Jorgeherrera-hub/Proyecto-Electr-nica-Biom-dica-/bioreactor v3/Guía de conexiones y funciones control del mini-biorreactor.docx

# Guía de conexiones y funciones: control del mini-biorreactor

Placa mini_biorreactor: 39 componentes y 4 agujeros de montaje. Los valores salen del esquemático generado y las conexiones, de la tabla de redes ya revisada contra la netlist.

## 1. Cómo usar esta guía

Para redibujar el esquemático en KiCad, trabaja por bloques (secciones 3.A a 3.G) y conecta con etiquetas de red (tecla L) usando exactamente los nombres de la sección 2, que son los de la placa. Así el esquemático coincide con la netlist. Al terminar, marca los pines no usados del ESP32 con la bandera de no conectado (sección 3.C), pon un PWR_FLAG en +12V_PROT y ejecuta el ERC.

Símbolos de KiCad que ya se confirmaron como existentes: RF_Module:ESP32-WROOM-32, Regulator_Linear:L7805 (solo como sustituto de U2, que físicamente es un OKI-78SR-5/1.5-W36-C), Regulator_Linear:LM1117T-3.3, Transistor_FET:IRLZ44N, BSS138, Device:D_Schottky, Connector:Conn_01xNN_Pin (headers y bornera), Switch:SW_Push, y Device:R y Device:C para resistencias y condensadores.

## 2. Redes (nombres iguales a los de la placa)

- +12V_IN: los 12 V que entran por la bornera, antes del diodo de protección.
- +12V_PROT: los 12 V después del diodo; alimentan el motor y el regulador de 5 V.
- +5V: salida del regulador de 5 V; alimenta la pantalla y el LM1117.
- +3V3: salida del LM1117; alimenta el ESP32 y los sensores.
- GND: tierra común.
- MOTOR-: terminal negativo del motor (drenaje del MOSFET).
- PWM_MOTOR: señal PWM del ESP32 (IO18).
- N$1: compuerta del MOSFET.
- N$2: botón ON/OFF (IO25).
- N$3: botón de regulación (IO26).
- EN, IO0: reinicio y modo de arranque del ESP32.
- TXD0, RXD0: puerto serie de programación.
- TEMP_DATA: dato de la sonda de temperatura (IO4).
- RPM_SIGNAL: pulsos del sensor de velocidad (IO19).
- SDA_3V3, SCL_3V3: I2C del lado del ESP32 (IO21, IO22).
- SDA_5V, SCL_5V: I2C del lado de la pantalla.

## 3. Conexiones por bloque (pin a pin)

### 3.A Entrada de alimentación y protección

- J1 (bornera de 2 pines): pin 1 → +12V_IN; pin 2 → GND.
- D1 (1N5819): ánodo (pin 2) → +12V_IN; cátodo (pin 1) → +12V_PROT.
- C1 (220 µF, 25 V): pin 1 → +12V_PROT; pin 2 → GND. Es polarizado: el terminal positivo va del lado de +12V_PROT (revisa la marca + de la serigrafía).
- C2 (100 nF): pin 1 → +12V_PROT; pin 2 → GND.

### 3.B Reguladores de 5 V y de 3,3 V

- U2 (OKI-78SR-5/1.5-W36-C, símbolo L7805): pin 1 (IN) → +12V_PROT; pin 2 (GND) → GND; pin 3 (OUT) → +5V.
- C3 (10 µF), C4 (100 nF), C5 (10 µF), C6 (100 nF): en los cuatro, pin 1 → +5V y pin 2 → GND. Se reparten entre la salida de U2 y la entrada de U3.
- U3 (LM1117T-3.3): pin 1 (GND) → GND; pin 2 (VO) → +3V3; pin 3 (VI) → +5V. Ojo: este orden de pines es distinto al del 7805.
- C7 (10 µF), C8 (100 nF), C9 (100 nF): en los tres, pin 1 → +3V3 y pin 2 → GND. C9 va junto al pin de alimentación del ESP32.

### 3.C ESP32, reinicio y programación

U1 (ESP32-WROOM-32), pines usados:

- Pin 2 (VDD) → +3V3.
- Pines 1, 15, 38 y 39 (GND) → GND.
- Pin 3 (EN) → EN.
- Pin 25 (IO0) → IO0.
- Pin 35 (TXD0/IO1) → TXD0.
- Pin 34 (RXD0/IO3) → RXD0.
- Pin 30 (IO18) → PWM_MOTOR.
- Pin 31 (IO19) → RPM_SIGNAL.
- Pin 26 (IO4) → TEMP_DATA.
- Pin 33 (IO21) → SDA_3V3.
- Pin 36 (IO22) → SCL_3V3.
- Pin 10 (IO25) → N$2.
- Pin 11 (IO26) → N$3.

Componentes de arranque:

- R1 (10 kΩ): pin 1 → +3V3; pin 2 → EN.
- C10 (100 nF): pin 1 → EN; pin 2 → GND.
- SW_EN: pin 1 → EN; pin 2 → GND.
- R2 (10 kΩ): pin 1 → +3V3; pin 2 → IO0.
- SW_BOOT: pin 1 → IO0; pin 2 → GND.
- J_PROG (6 pines): 1 → +3V3; 2 → TXD0; 3 → RXD0; 4 → EN; 5 → IO0; 6 → GND.

Pines de U1 sin uso (ponles la bandera de no conectado): SENSOR_VP (4), SENSOR_VN (5), IO34 (6), IO35 (7), IO32 (8), IO33 (9), IO27 (12), IO14 (13), IO12 (14), IO13 (16), SHD/SD2 (17), SWP/SD3 (18), SCS/CMD (19), SCK/CLK (20), SDO/SD0 (21), SDI/SD1 (22), IO15 (23), IO2 (24), IO16 (27), IO17 (28), IO5 (29) e IO23 (37).

### 3.D Control del motor

- R3 (100 Ω): pin 1 → PWM_MOTOR; pin 2 → N$1.
- R4 (10 kΩ): pin 1 → N$1; pin 2 → GND.
- Q1 (IRLZ44N): pin 1 (G) → N$1; pin 2 (D) → MOTOR-; pin 3 (S) → GND.
- J_MOTOR (2 pines): pin 1 → +12V_PROT; pin 2 → MOTOR-.
- D2 (1N5819): cátodo (pin 1) → +12V_PROT; ánodo (pin 2) → MOTOR-.
- C11 (100 nF): pin 1 → +12V_PROT; pin 2 → MOTOR-.

### 3.E Sensores

- J_TEMP (3 pines): 1 → +3V3; 2 → TEMP_DATA; 3 → GND.
- R5 (4,7 kΩ): pin 1 → +3V3; pin 2 → TEMP_DATA.
- J_RPM (3 pines): 1 → +3V3; 2 → RPM_SIGNAL; 3 → GND.
- R6 (10 kΩ): pin 1 → +3V3; pin 2 → RPM_SIGNAL.

### 3.F Pantalla LCD por I2C (con adaptador de nivel)

- Q2 (BSS138, línea SDA): pin 1 (G) → +3V3; pin 2 (S) → SDA_3V3; pin 3 (D) → SDA_5V.
- R7 (10 kΩ): pin 1 → +3V3; pin 2 → SDA_3V3.
- R8 (10 kΩ): pin 1 → +5V; pin 2 → SDA_5V.
- Q3 (BSS138, línea SCL): pin 1 (G) → +3V3; pin 2 (S) → SCL_3V3; pin 3 (D) → SCL_5V.
- R9 (10 kΩ): pin 1 → +3V3; pin 2 → SCL_3V3.
- R10 (10 kΩ): pin 1 → +5V; pin 2 → SCL_5V.
- J_LCD (4 pines): 1 → GND; 2 → +5V; 3 → SDA_5V; 4 → SCL_5V.

### 3.G Botones

- SW_ON: pin 1 → N$2; pin 2 → GND.
- SW_REG: pin 1 → N$3; pin 2 → GND.
- No llevan resistencia externa: el firmware debe activar las resistencias internas de pull-up de IO25 e IO26.

## 4. Función de cada componente

### Alimentación

- J1: bornera donde entra la fuente de 12 V.
- D1: protección contra polaridad invertida. Si conectas la fuente al revés, el diodo no deja pasar corriente. A cambio, cae unas décimas de voltio.
- C1: reserva de energía del riel de 12 V; amortigua los picos que genera el motor.
- C2: filtra el ruido de alta frecuencia del riel de 12 V.
- U2: regulador conmutado que baja 12 V a 5 V. Es mucho más eficiente que un 7805 y no se calienta como él. Alimenta solo la parte lógica; el motor toma los 12 V directamente.
- C3 a C6: estabilizan y filtran el riel de 5 V, a la salida de U2 y a la entrada de U3.
- U3: regulador lineal que baja 5 V a 3,3 V para el ESP32 y los sensores.
- C7 a C9: estabilizan la salida de 3,3 V. El LM1117 necesita un condensador de salida para ser estable, y C9 desacopla el ESP32.

### Microcontrolador y arranque

- U1 (ESP32-WROOM-32): el cerebro. Genera el PWM del motor, mide temperatura y RPM, maneja la pantalla y los botones, y trae WiFi y Bluetooth.
- R1: pull-up de EN; mantiene el ESP32 encendido.
- C10: filtra rebotes y da un pequeño retardo de arranque en EN.
- SW_EN: reinicio manual (lleva EN a GND).
- R2: pull-up de IO0; asegura el arranque normal.
- SW_BOOT: al mantenerlo pulsado mientras se reinicia, el ESP32 entra en modo de programación.
- J_PROG: conexión del adaptador USB-UART para cargar el programa. Con 12 V presentes, no conectes el pin 3V3 del adaptador.

### Motor (agitación)

- Q1 (IRLZ44N): interruptor electrónico. El ESP32 lo enciende y apaga muy rápido (PWM) y así regula la velocidad del agitador.
- R3: limita la corriente de carga de la compuerta, lo que suaviza los cambios y reduce ruido.
- R4: pull-down de la compuerta; mantiene el MOSFET apagado mientras el ESP32 arranca, para que el motor no gire solo al encender.
- D2: diodo de rueda libre. Absorbe el pico de tensión que produce el motor (una carga inductiva) cuando el MOSFET se apaga, y protege a Q1.
- C11: reduce el ruido eléctrico del motor.
- J_MOTOR: conector del motor de 6 V.

### Sensores

- J_TEMP: conector de la sonda de temperatura DS18B20 (3 hilos).
- R5: pull-up de 4,7 kΩ del bus de datos de la sonda; el DS18B20 lo necesita para comunicarse.
- J_RPM: conector del sensor Hall que mide la velocidad de agitación.
- R6: pull-up de la salida del sensor de velocidad.

### Pantalla

- J_LCD: conector de la pantalla LCD 16x2 con módulo I2C, que funciona a 5 V.
- Q2 y Q3 (BSS138): adaptador de nivel bidireccional entre el I2C de 3,3 V del ESP32 y el de 5 V de la pantalla (uno para SDA y otro para SCL). Protegen los pines del ESP32.
- R7 y R9: pull-ups de 3,3 V de SDA y SCL. R8 y R10: pull-ups de 5 V de SDA y SCL. Trabajan junto con Q2 y Q3.

### Botones

- SW_ON: enciende y apaga el agitador.
- SW_REG: regulación de velocidad. Con un solo botón, el firmware debe ciclar entre velocidades predefinidas.

### Mecánica

- H1 a H4: cuatro agujeros de montaje M3 para fijar la placa.

## 5. Piezas externas conectadas a la placa (no están en ella)

- Motor DC de 6 V → J_MOTOR.
- Sensor Hall con un imán en el eje → J_RPM.
- Sonda DS18B20 impermeable → J_TEMP.
- Pantalla LCD 16x2 con módulo I2C → J_LCD.
- Adaptador USB-UART → J_PROG (solo GND, TX y RX).
- Fuente de 12 V → J1.

## 6. Notas importantes

- El motor es de 6 V y el riel es de 12 V: el firmware debe limitar el PWM a un 50 % como máximo. Se sugiere una frecuencia de unos 20 kHz.
- D1 y D2 (1N5819) soportan 1 A: confirma que el motor no consuma más.
- C1 es polarizado. Si C3, C5 o C7 resultan ser electrolíticos y no cerámicos, el terminal positivo va al riel (+5V o +3V3).
- Qué condensadores de 10 µF y 100 nF están más cerca de U2 y cuáles de U3 no lo da la tabla de redes; en el esquemático basta con conectarlos al riel que corresponde.

## 7. Lista de verificación al redibujar

1. Coloca los 39 componentes con las mismas referencias y valores.
2. Conecta bloque por bloque con etiquetas de red de la sección 2.
3. Marca los 22 pines no usados de U1 con la bandera de no conectado.
4. Pon un PWR_FLAG en +12V_PROT.
5. Ejecuta el ERC y revisa que no queden errores.
6. Ejecuta el DRC de la placa con la comprobación de paridad con el esquemático (solo compara, no cambia nada).
