Jorgeherrera-hub/Proyecto-Electr-nica-Biom-dica-/bioreactor v3/Poryecto_bioreactor/Hoja de conexiones v3 control del mini-biorreactor con Arduino Nano R3.docx

# Hoja de conexiones v3: control del mini-biorreactor con Arduino Nano R3

Versión 3: la placa de desarrollo central pasa de ESP32 a Arduino Nano R3 (ATmega328P, lógica de 5 V). Parte del diseño v2 ya revisado. Las características de la Nano que se usan (pines PWM, interrupciones, I2C en A4 y A5, lógica de 5 V, VIN de 7 a 12 V) son estándar de la placa. Los nombres exactos de símbolo y huella en KiCad debes confirmarlos en tu selector, y el módulo de alarma, los sensores y la Nano concreta tienen puntos por confirmar al final (sección 4).

- El conversor del Arduino Nano R3 es CH340

## 1. Análisis de cambios (ESP32 frente a Arduino Nano R3)

### Lógica y voltajes

- El ESP32 trabaja a 3,3 V y la Nano a 5 V: todas las señales de la Nano son de 5 V.
- Se elimina el regulador U3 (LM1117T-3.3) junto con C7 y C8, y desaparece la red +3V3. Todo el circuito pasa a funcionar con la red +5V.
- Se elimina el adaptador de nivel I2C (Q3, R9 y R10). El I2C va directo de la Nano (5 V) a la pantalla (5 V). Q2, R7 y R8 se reutilizan como driver de la alarma.
- J_TEMP pin 1, J_RPM pin 1, R5 y R6 pasan de +3V3 a +5V. La sonda DS18B20 acepta 5 V (confirmado). Para el sensor de RPM se recomienda un módulo Hall A3144 (ver 2.E).
- La compuerta del IRLZ44N pasa a excitarse con 5 V desde la Nano, lo cual lo satura mejor que con 3,3 V.

### Alimentación

- La Nano se alimenta por su pin +5V desde la salida del buck U2. Los pines VIN y +3V3 de la Nano quedan sin conectar.
- Motivo de no usar VIN: pasa por el regulador lineal de la Nano, que con unos 11,6 V de entrada se calentaría y desperdiciaría potencia. El buck U2 es más eficiente.
- El pin +3V3 de la Nano sale del chip USB y entrega muy poca corriente, así que no se usa.

### Asignación de pines (ESP32 a Nano)

- PWM_MOTOR: de IO18 a D9. D9 es una salida PWM del Timer1, que permite subir la frecuencia a unos 31 kHz (fuera del rango audible) sin afectar a millis().
- RPM_SIGNAL: de IO19 a D2, que es la interrupción externa INT0. Es el pin ideal para contar pulsos.
- TEMP_DATA: de IO4 a D4 (bus OneWire; funciona en cualquier pin digital).
- SDA: de IO21 a A4. SCL: de IO22 a A5. En la Nano el I2C por hardware es fijo en esos dos pines.
- Botón ON/OFF (SW_ON): de IO25 a D5. Botón de regulación (SW_REG): de IO26 a D6.
- Navegación (SW_NAV): nuevo, en D7. Reutiliza el pulsador que era SW_BOOT.
- Alarma: nuevo, en D8.
- Reinicio (SW_RESET): va al pin ~RESET. Reutiliza el pulsador que era SW_EN.

### Botones en la carcasa

- Los botones de ON/OFF, regulación y navegación (D5, D6 y D7) pasan a ser botones de panel en la carcasa, conectados a la PCB por conectores de 2 pines: J_BTN_ON, J_BTN_REG y J_BTN_NAV.
- SW_RESET se queda en la PCB, dentro de la carcasa: un reinicio accidental desde el panel interrumpiría el control del agitador.
- Los nombres de red y los pines de la Nano no cambian: solo cambia dónde está físicamente cada interruptor.

### Interrupciones, PWM e I2C

- Interrupciones externas por hardware: solo D2 (INT0) y D3 (INT1). D3 queda libre y reservada.
- Pines con PWM: D3, D5, D6, D9, D10 y D11.
- A6 y A7 son solo entradas analógicas (no sirven como digitales ni tienen pull-up).
- D13 tiene el LED de la placa: no la uses para botones.

### Programación y reinicio

- La Nano se programa por su puerto USB con el bootloader. No existen los pines EN, IO0 ni BOOT del ESP32.
- D0 (RX) y D1 (TX) se comparten con el conversor USB: se dejan sin conexión.
- Por eso se elimina J_PROG, y R1 y R2 (pull-ups de EN e IO0) dejan de tener sentido.

### Corriente por pin y capacidades que se pierden

- Corriente recomendada por pin de la Nano: 20 mA (máximo absoluto 40 mA). Por eso la alarma se maneja con un transistor y no directo desde el pin.
- Se pierden WiFi y Bluetooth. La Nano tiene 2 KB de RAM, 32 KB de flash y un ADC de 10 bits: el firmware debe ser compacto.

### Resumen de componentes

- Salen: U3, C7, C8, Q3, R1, R2, R9, R10, J_PROG y la red +3V3. También las tiras hembra del ESP32, que se reemplazan por las de la Nano.
- Cambian de función: SW_EN pasa a SW_RESET; SW_BOOT pasa a SW_NAV; Q2, R7 y R8 pasan al driver de la alarma.
- Entran: D3 (diodo de la alarma) y J_ALARM. Además R11 y R12 como pull-ups I2C opcionales.
- Total: 31 componentes, más 2 opcionales (R11 y R12) y 4 agujeros de montaje M3.
- La PCB v2 deja de servir: cambian la huella de la placa central y varias conexiones, así que hay que rehacer la placa.

## 2. Lista de conexiones detallada (pin a pin)

### 2.0 Redes de esta versión

+12V_IN, +12V_PROT, +5V, GND, MOTOR-, PWM_MOTOR, GATE_Q1 (antes N$1), TEMP_DATA, RPM_SIGNAL, SDA, SCL, BTN_ON (antes N$2), BTN_REG (antes N$3), BTN_NAV, RESET, ALARM_CTRL, ALARM_GATE y ALARM-.

Los pines de la Nano se identifican por su nombre en el símbolo, no por su número, porque la numeración física puede variar entre símbolo y placa. Los nombres pueden llevar texto extra (por ejemplo D9/PWM): busca el D9.

### 2.A Entrada de alimentación y protección

- El pin 1 de J1 (bornera, entrada de 12 V) se conecta al pin 2 (ánodo) de D1 (net +12V_IN). (1. listo)
- El pin 2 de J1 se conecta a la net GND. (2. listo)
- El pin 1 (cátodo) de D1 (1N5819) se conecta a la net +12V_PROT (protección contra polaridad invertida). (3. listo)
- El pin 1 (+) de C1 (220 µF, 25 V, polarizado) se conecta a la net +12V_PROT; su pin 2 (−) se conecta a la net GND. (4. listo)
- El pin 1 de C2 (100 nF) se conecta a la net +12V_PROT; su pin 2 se conecta a la net GND. (5. listo)

### 2.B Regulación a 5 V

- El pin 1 (IN) de U2 (OKI-78SR-5/1.5-W36-C, dibujado con el símbolo L7805) se conecta a la net +12V_PROT. (6. Listo)
- El pin 2 (GND) de U2 se conecta a la net GND. (7. listo)
- El pin 3 (OUT) de U2 se conecta al pin +5V de U1 (net +5V). (8. listo)
- El pin 1 de C3 (10 µF) se conecta a la net +5V; su pin 2 se conecta a la net GND. (9. listo)
- El pin 1 de C4 (100 nF) se conecta a la net +5V; su pin 2 se conecta a la net GND. (10. listo)
- El pin 1 de C5 (10 µF) se conecta a la net +5V, junto al pin +5V de U1; su pin 2 se conecta a la net GND. (11. listo)
- El pin 1 de C6 (100 nF) se conecta a la net +5V, junto al pin +5V de U1; su pin 2 se conecta a la net GND. (12. listo)

### 2.C Microcontrolador: Arduino Nano R3 (U1)

U1 se dibuja con el símbolo MCU_Module:Arduino_Nano_v3.x y se monta con dos tiras hembra (J_NANO_L y J_NANO_R) o con la huella Module:Arduino_Nano. Confirma ambos nombres en tu selector.

Por decisiones de diseño (debatir con el grupo), pretendo no ocupar las dos tiras hembras si no que montar directamente la placa sobre la PCB

Alimentación:

- El pin +5V de U1 se conecta al pin 3 (OUT) de U2 (net +5V). La Nano recibe aquí 5 V ya regulados. (13. listo)
- Los pines GND de U1 (hay dos) se conectan a la net GND. (14. listo)
- El pin VIN de U1 queda sin conectar (bandera de no conectado). (15. listo)
- El pin +3V3 de U1 queda sin conectar (bandera de no conectado). (16. Listo)
- El pin AREF de U1 queda sin conectar (bandera de no conectado). (17. Listo)

Señales:

- El pin D9 de U1 se conecta al pin 1 de R3 (net PWM_MOTOR). (18. listo)
- El pin D2 de U1 se conecta al pin 2 de J_RPM y al pin 2 de R6 (net RPM_SIGNAL). (19. Listo)
- El pin D4 de U1 se conecta al pin 2 de J_TEMP y al pin 2 de R5 (net TEMP_DATA). (20. Listo)
- El pin A4 de U1 se conecta al pin 3 de J_LCD (net SDA). (21. Listo)
- El pin A5 de U1 se conecta al pin 4 de J_LCD (net SCL). (22. Listo)
- El pin D5 de U1 se conecta al pin 1 de J_BTN_ON (net BTN_ON). (23. Listo)
- El pin D6 de U1 se conecta al pin 1 de J_BTN_REG (net BTN_REG). (24. Listo)
- El pin D7 de U1 se conecta al pin 1 de J_BTN_NAV (net BTN_NAV). (25. Listo)
- El pin D8 de U1 se conecta al pin 1 de R7 (net ALARM_CTRL). (26. Listo)
- El pin ~RESET de U1 se conecta al pin 1 de SW_RESET (net RESET). Si el símbolo muestra dos pines ~RESET, conecta ambos a la net RESET. (27. Lista)

Pines de U1 sin uso (bandera de no conectado): D0/RX y D1/TX (reservados al USB), D3, D10, D11, D12, D13, A0, A1, A2, A3, A6 y A7. (listo)

### 2.D Control del motor DC

- El pin 2 de R3 (100 Ω) se conecta al pin 1 (G) de Q1 (IRLZ44N) y al pin 1 de R4 (net GATE_Q1). (27. Listo)
- El pin 2 de R4 (10 kΩ) se conecta a la net GND (mantiene Q1 apagado mientras la Nano arranca). (28. Listo)
- El pin 3 (S) de Q1 se conecta a la net GND. (29. Listo)
- El pin 2 (D) de Q1 se conecta al pin 2 de J_MOTOR, al pin 2 (ánodo) de D2 y al pin 2 de C11 (net MOTOR-). (30. Listo)
- El pin 1 de J_MOTOR (conector del motor de 6 V) se conecta a la net +12V_PROT. (31. Listo)
- El pin 1 (cátodo) de D2 (1N5819, diodo de rueda libre) se conecta a la net +12V_PROT. (32. Listo)
- El pin 1 de C11 (100 nF, reduce el ruido del motor) se conecta a la net +12V_PROT. (33. Listo)

### 2.E Sensores

- El pin 1 de J_TEMP (sonda DS18B20) se conecta a la net +5V. (34. listo)
- El pin 2 de J_TEMP se conecta al pin D4 de U1 y al pin 2 de R5 (net TEMP_DATA). (ya se hizo en un paso previo)
- El pin 3 de J_TEMP se conecta a la net GND. (35. Listo)
- El pin 1 de R5 (4,7 kΩ, pull-up obligatorio del bus OneWire) se conecta a la net +5V. (36. Listo)
- El pin 1 de J_RPM (sensor Hall de velocidad) se conecta a la net +5V. (37. Listo)
- El pin 2 de J_RPM se conecta al pin D2 de U1 y al pin 2 de R6 (net RPM_SIGNAL). Ya se hizo en un paso previo
- El pin 3 de J_RPM se conecta a la net GND. (38. Listo)
- El pin 1 de R6 (10 kΩ, pull-up de la salida del sensor) se conecta a la net +5V. (39. Listo)

Sensor de RPM recomendado: módulo Hall con A3144 (tipo KY-003) y un imán de neodimio. (Decisión personal (debatir con el grupo): usarlo)

- El A3144 funciona con 4,5 a 24 V, así que acepta los 5 V de la placa. Su salida es de colector abierto: R6 (10 kΩ a +5V) es el pull-up que necesita.
- Es unipolar: solo responde a un polo del imán. Pega un imán pequeño en la parte giratoria; si el LED del módulo no se enciende al acercarlo, gira el imán.
- Con un imán da 1 pulso por vuelta. Para equilibrar la pieza giratoria puedes poner dos imanes opuestos con el mismo polo hacia afuera: son 2 pulsos por vuelta y el firmware divide por 2.
- Los módulos suelen venir con el orden S, +, − (señal, 5 V, GND), distinto al de J_RPM (+5V, señal, GND). Cablea según las etiquetas del módulo, no por posición.
- Colócalo a pocos milímetros de la parte giratoria y ajusta la distancia hasta que el LED conmute con claridad.
- Si el ruido del motor produce conteos falsos, añade 100 nF entre señal y GND junto al sensor, o filtra por software.

### 2.F Pantalla LCD por I2C

- El pin 1 de J_LCD (pantalla 16x2 con módulo I2C) se conecta a la net GND. (40. Listo)-→ Esto significa que la pantalla puede presentar hasta 16 carácteres, con dos lineas de alto. El modulo I2C permite eficiencia en el cableado.
- El pin 2 de J_LCD se conecta a la net +5V. (41. Listo)
- El pin 3 de J_LCD se conecta al pin A4 de U1 (net SDA). (Realizado en paso previo)
- El pin 4 de J_LCD se conecta al pin A5 de U1 (net SCL). (Realizado en paso previo)
- R11 (4,7 kΩ, opcional): su pin 1 se conecta a la net +5V y su pin 2 a la net SDA. (42. Listo)
- R12 (4,7 kΩ, opcional): su pin 1 se conecta a la net +5V y su pin 2 a la net SCL. (43. Listo)
- No montes R11 ni R12 si tu módulo I2C ya trae pull-ups (la mayoría los trae).

### 2.G Botones de la carcasa y reinicio

Los tres botones de control van en la carcasa y cada uno se conecta a la PCB con un conector de 2 pines. Un pulsador no tiene polaridad, así que el cable se puede enchufar en cualquier sentido. SW_RESET se queda en la PCB a propósito.

- El pin 1 de J_BTN_ON se conecta al pin D5 de U1 (net BTN_ON); su pin 2 se conecta a la net GND. Botón de panel ON/OFF: enciende y apaga el agitador. (44. Listo)
- El pin 1 de J_BTN_REG se conecta al pin D6 de U1 (net BTN_REG); su pin 2 se conecta a la net GND. Botón de panel de regulación de velocidad. (45. Listo)
- El pin 1 de J_BTN_NAV se conecta al pin D7 de U1 (net BTN_NAV); su pin 2 se conecta a la net GND. Botón de panel de navegación de menús (propuesta). (46. Listo)
- C12 (100 nF, opcional): su pin 1 se conecta a la net BTN_ON y su pin 2 a la net GND, junto a J_BTN_ON. (47. Listo)
- C13 (100 nF, opcional): su pin 1 se conecta a la net BTN_REG y su pin 2 a la net GND, junto a J_BTN_REG. (48. Listo)
- C14 (100 nF, opcional): su pin 1 se conecta a la net BTN_NAV y su pin 2 a la net GND, junto a J_BTN_NAV. (49. Listo)
- El pin 1 de SW_RESET (pulsador en la PCB) se conecta al pin ~RESET de U1 (net RESET); su pin 2 se conecta a la net GND. Reinicio manual para mantenimiento. (50. Listo (recordar que se decidió ocupar un modulo en vez del switch directo))
- Ninguno de los botones lleva resistencia externa: el firmware activa los pull-up internos (INPUT_PULLUP) en D5, D6 y D7, y filtra los rebotes por software.

Cableado de los botones de la carcasa:

- Usa pulsadores de panel normalmente abiertos y de contacto momentáneo, de 12 a 16 mm, de preferencia sellados contra salpicaduras (IP65 o superior), porque el biorreactor trabaja con líquidos y se limpia con desinfectantes.
- Cada botón va con un par de cables que termina en un conector hembra de 2 pines para su J_BTN. Mantén los cables cortos (idealmente 30 cm o menos), trenzados y lejos del cable del motor.
- Si aparecen pulsaciones falsas por el ruido del motor, monta los condensadores C12 a C14 junto a cada conector o refuerza el filtro de rebotes por software.
- Rotula cada conector en la serigrafía (BTN ON, BTN REG, BTN NAV).

### 2.H Alarma

- El pin D8 de U1 se conecta al pin 1 de R7 (1 kΩ) (net ALARM_CTRL). (realizado en paso previo)
- El pin 2 de R7 se conecta al pin 1 (G) de Q2 (BSS138) y al pin 1 de R8 (net ALARM_GATE). (51. Listo)
- El pin 2 de R8 (10 kΩ, pull-down) se conecta a la net GND. (52. Listo)
- El pin 2 (S) de Q2 se conecta a la net GND. (53. Listo)
- El pin 3 (D) de Q2 se conecta al pin 2 de J_ALARM y al pin 2 (ánodo) de D3 (net ALARM-). (54. Listo)
- El pin 1 de J_ALARM (buzzer activo de 5 V, conector de 2 pines) se conecta a la net +5V. (55. Listo)
- El pin 1 (cátodo) de D3 (1N5819, rueda libre para zumbadores magnéticos; inofensivo con piezoeléctricos) se conecta a la net +5V. (56. Listo)

### 2.I Conector de programación y UART

- No corresponde: la Nano se programa por su puerto USB. D0 y D1 quedan sin conexión y J_PROG se elimina.
- Si más adelante quieres un header de depuración serie, usa uno de 3 pines (TX, RX, GND) conectado a D1, D0 y GND, y nunca lo uses a la vez que el USB.

### 2.J Mecánica

- H1 a H4: cuatro agujeros de montaje M3, sin conexión eléctrica.

## 3. Notas de seguridad y comprobaciones

- Motor de 6 V con riel de 12 V: el firmware debe limitar el PWM a un 50 % como máximo (por ejemplo analogWrite de 127 o menos). Para subir la frecuencia, configura el Timer1 en D9.
- Diodos D1, D2 y D3 (1N5819): soportan 1 A. Confirma que el motor no consuma más.
- No uses el pin VIN para alimentar la Nano desde los 12 V.
- USB y 12 V a la vez: no conectes el USB mientras la PCB esté alimentada con 12 V, salvo que sepas que tu Nano aísla el USB con un diodo. Los clones varían. Programa con la PCB apagada.
- Pines y polaridad: C1, C3 y C5 son polarizados si resultan electrolíticos; el positivo va al riel.
- ERC: pon un PWR_FLAG en +12V_PROT. Si el ERC marca dos salidas de alimentación conectadas (U2 pin 3 y el pin +5V de la Nano), es esperable y no es un error de conexión: se resuelve con una excepción de ERC o cambiando el tipo de ese pin en una copia del símbolo.
- Al terminar de dibujar: cuenta 31 componentes (más R11, R12 y C12 a C14 opcionales) y 4 agujeros; confirma que U3, C7, C8, Q3, R1, R2, R9, R10 y J_PROG no aparecen; y revisa que no exista ninguna red +3V3.

## 4. Datos por confirmar

- Módulo de alarma: confirmado: buzzer activo de 5 V de 2 hilos. El driver de la alarma (Q2, R7, R8 y D3) se mantiene como está en 2.H.
- Sensor de RPM: se recomienda un módulo Hall con A3144 (acepta 5 V; ver 2.E). Cualquier otro modelo debe aceptar 5 V y tener salida digital.
- Nano concreta: original o clon, y qué conversor USB lleva (FT232 o CH340).
- SW_NAV: es una propuesta (botón de navegación en el panel). Si no quieres un tercer botón de control, elimina J_BTN_NAV y deja D7 libre.
- Símbolos y huellas: confirma MCU_Module:Arduino_Nano_v3.x y Module:Arduino_Nano en tu instalación. Si montas la Nano en dos tiras hembra, usa dos PinSocket_1x15_P2.54mm_Vertical con 15,24 mm entre filas (comprueba midiendo tu placa). Q2 usa SOT-23; D3 usa la misma huella que D1 y D2; J_ALARM, J_BTN_ON, J_BTN_REG y J_BTN_NAV usan PinHeader_1x02_P2.54mm_Vertical.
