Jorgeherrera-hub/Proyecto-Electr-nica-Biom-dica-/Esquemático/mini_biorreactor.pdf

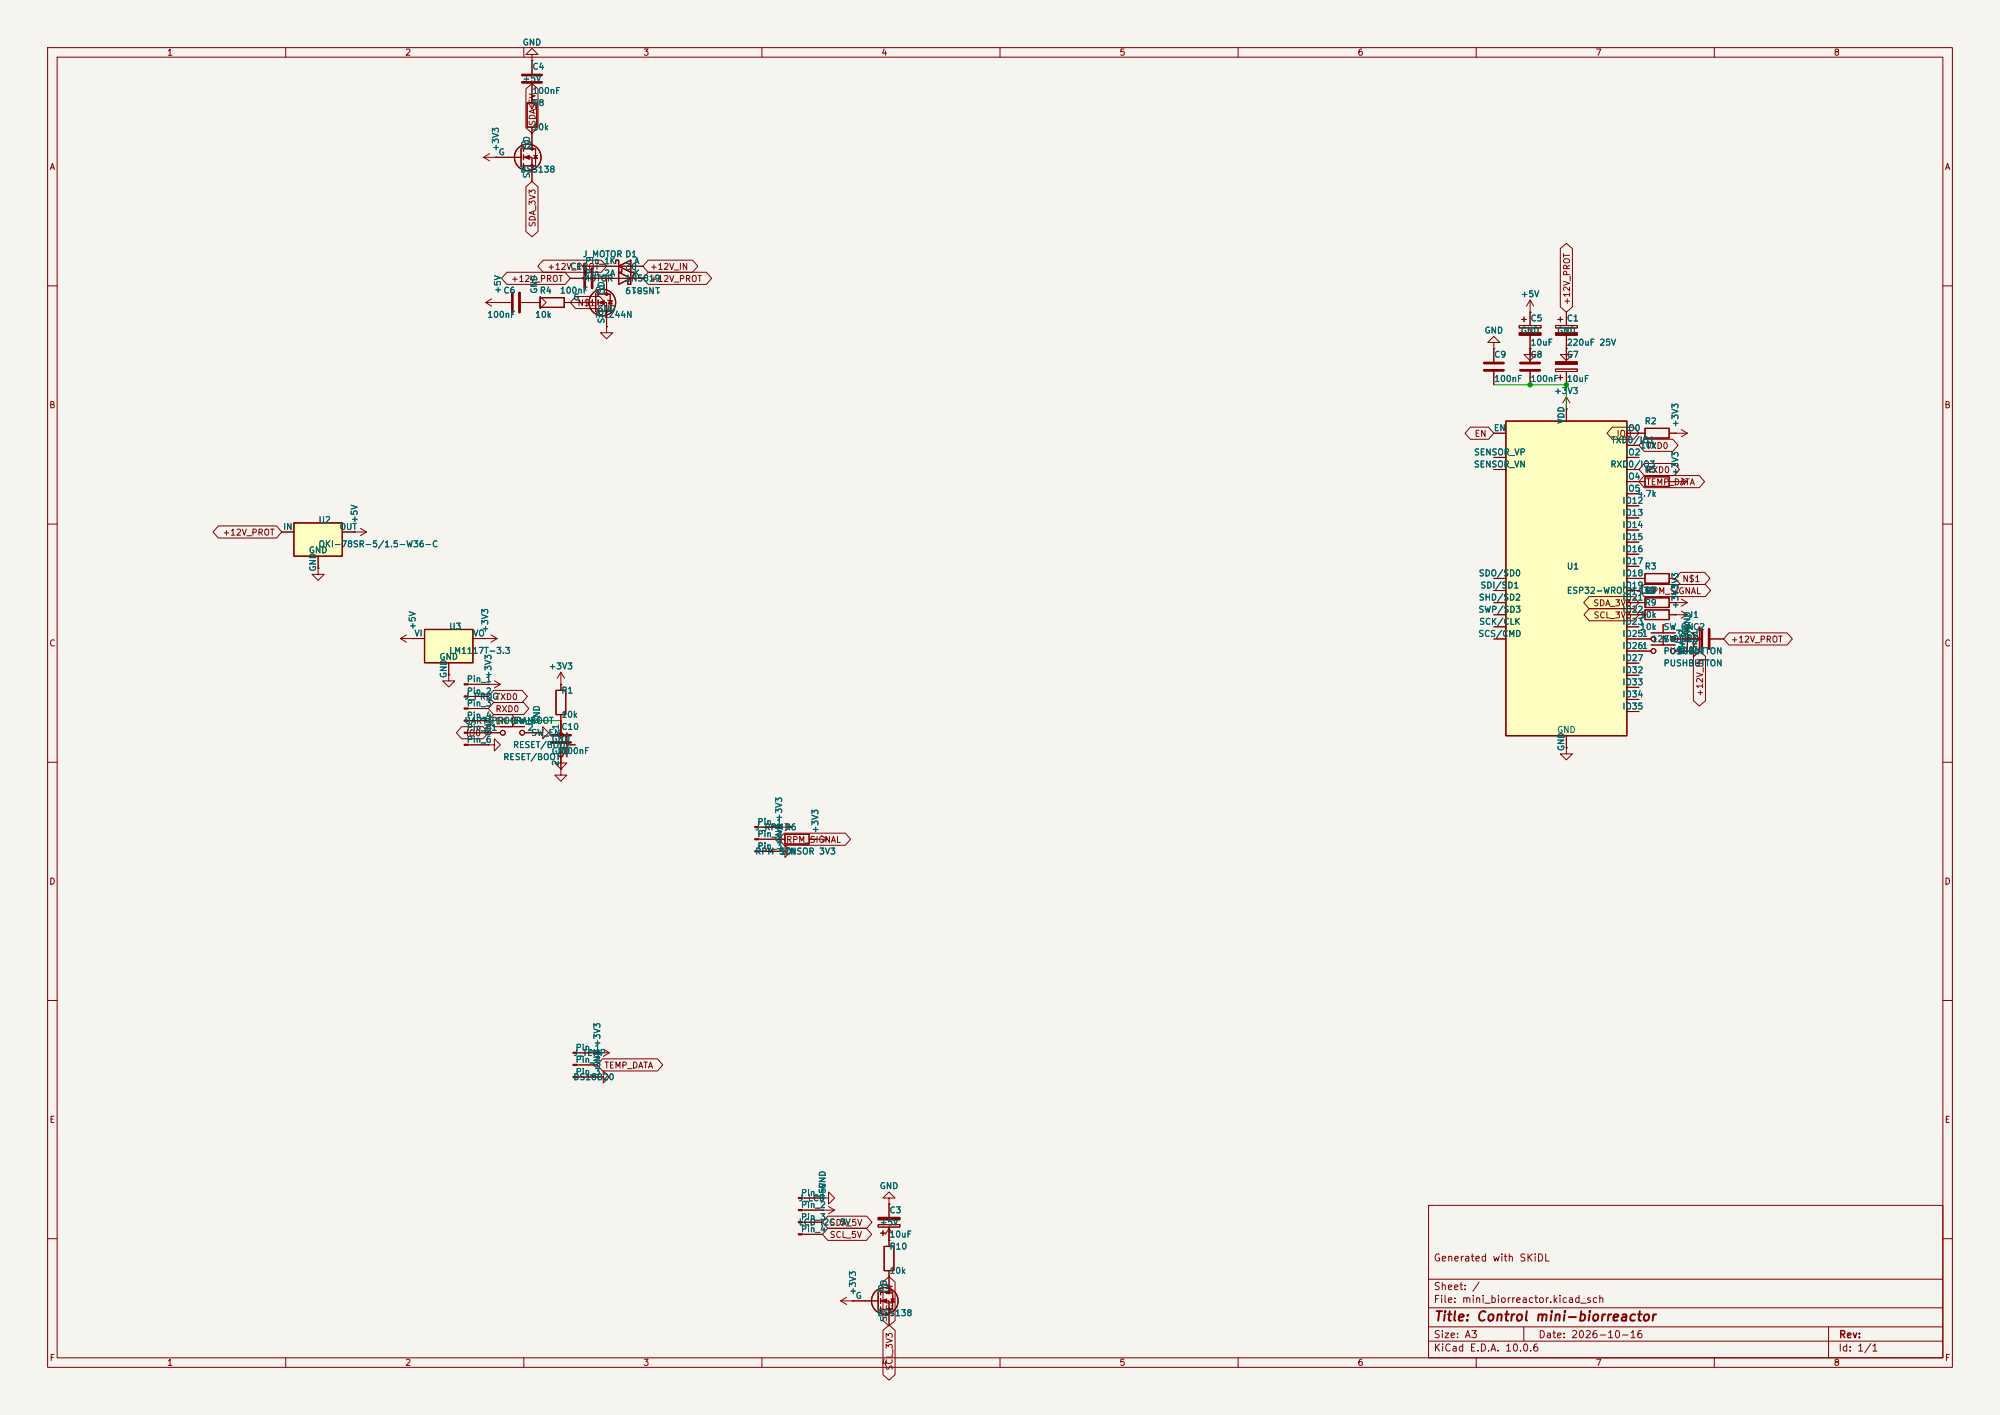
[picture p1: page 1]

Sheet: /
File: mini_biorreactor.kicad_sch
Title: Control mini-biorreactor

Size: A3 | Rev:
KiCad E.D.A. 10.0.6 | Id: 1/1
