Jorgeherrera-hub/Proyecto-Electr-nica-Biom-dica-/(list of files, drawings)

Other design files:
mini_biorreactor_final.dsn
