Jorgeherrera-hub/Proyecto-Electr-nica-Biom-dica-/bioreactor final/Proyecto_bioreactor.kicad_pcb

## KiCad design bioreactor final/Proyecto_bioreactor.kicad_pcb (2026-10-30)

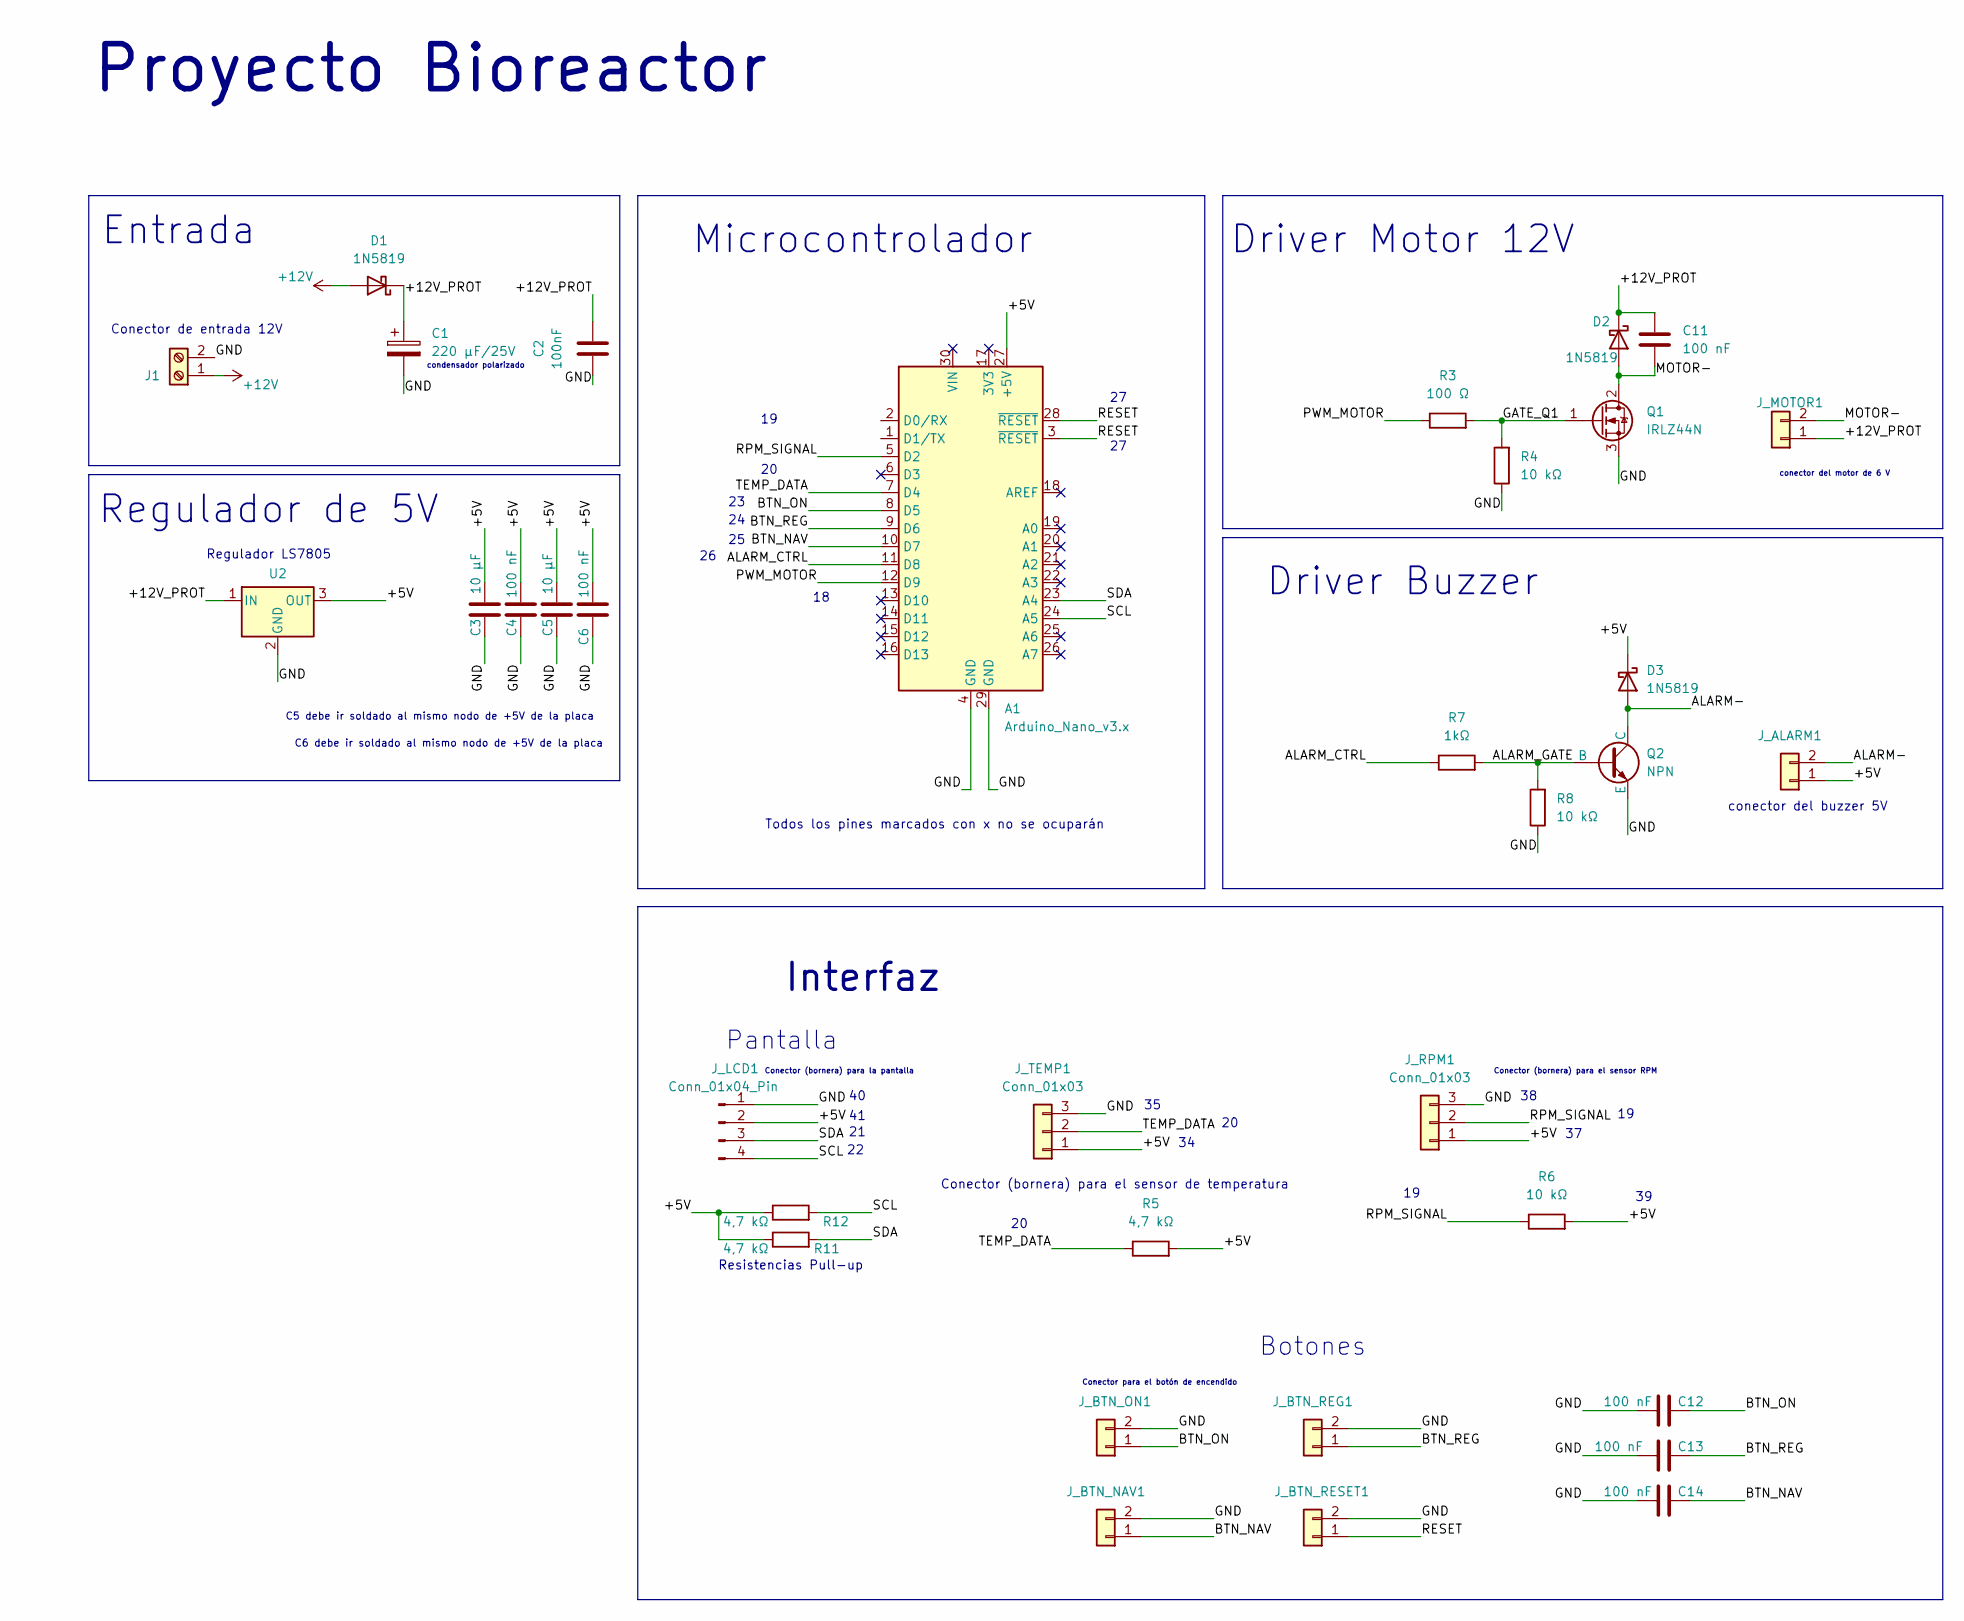
[picture p2: schematic Proyecto_bioreactor.kicad_sch]

Parts:
A1: Arduino_Nano_v3.x; Arduino_Nano
C1: 220 µF/25V; CP_Radial_D8.0mm_P3.50mm
C2: 100nF; C_Disc_D5.0mm_W2.5mm_P5.00mm
C3, C5: 10 µF; CP_Radial_D5.0mm_P2.00mm
C4, C6, C11, C12, C13, C14: 100 nF; C_Disc_D5.0mm_W2.5mm_P5.00mm
D1, D2, D3: 1N5819; D_DO-41_SOD81_P10.16mm_Horizontal
J1: Screw_Terminal_01x02; TerminalBlock_Phoenix_MKDS-1,5-2-5.08_1x02_P5.08mm_Horizont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
J_ALARM1: PinHeader_1x02_P2.54mm_Vertical
J_BTN_NAV1: PinHeader_1x02_P2.54mm_Vertical
J_BTN_ON1: PinHeader_1x02_P2.54mm_Vertical
J_BTN_REG1: PinHeader_1x02_P2.54mm_Vertical
J_BTN_RESET1: PinHeader_1x02_P2.54mm_Vertical
J_LCD1: Conn_01x04_Pin; PinHeader_1x04_P2.54mm_Vertical
J_MOTOR1: PinHeader_1x02_P2.54mm_Vertical; TerminalBlock_Phoenix_MKDS-1,5-2-5.08_1x02_P5.08mm_Horizont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
J_RPM1: Conn_01x03; PinHeader_1x03_P2.54mm_Vertical
J_TEMP1: Conn_01x03; PinHeader_1x03_P2.54mm_Vertical
Q1: IRLZ44N; TO-220-3_Vertical
Q2: NPN; TO-92
R3: 100 Ω; R_Axial_DIN0204_L3.6mm_D1.6mm_P7.62mm_Horizontal
R4, R6, R8: 10 kΩ; R_Axial_DIN0204_L3.6mm_D1.6mm_P7.62mm_Horizontal
R5, R11, R12: 4,7 kΩ; R_Axial_DIN0204_L3.6mm_D1.6mm_P7.62mm_Horizontal
R7: 1kΩ; R_Axial_DIN0204_L3.6mm_D1.6mm_P7.62mm_Horizontal
U2: OKI-78SR-5/1.5-W36-C (L7805); Converter_DCDC_Murata_OKI-78SR_Vertical

Connections:
+12V: D1.2 (A), J1.1
/+5V: A1.27 (+5V), C3.1, C4.1, C5.1, C6.1, D3.1 (K), J_ALARM1.1, J_LCD1.2, J_RPM1.1, J_TEMP1.1, R5.2, R6.2, R11.1, R12.1, U2.3 (OUT)
/+12V_PROT: C1.1, C2.2, C11.1, D1.1 (K), D2.1 (K), J_MOTOR1.1, U2.1 (IN)
/ALARM-: D3.2 (A), J_ALARM1.2, Q2.3 (C)
/ALARM_CTRL: A1.11 (D8), R7.1
/ALARM_GATE: Q2.2 (B), R7.2, R8.2
/BTN_NAV: A1.10 (D7), J_BTN_NAV1.1
/BTN_NAV: C14.1
/BTN_ON: A1.8 (D5), C12.1, J_BTN_ON1.1
/BTN_REG: A1.9 (D6), J_BTN_REG1.1
/BTN_REG: C13.1
/GATE_Q1: Q1.1 (G), R3.2, R4.2
/GND: A1.4 (GND), A1.29 (GND), C1.2, C2.1, C3.2, C4.2, C5.2, C6.2, C12.2, C13.2, C14.2, J1.2, J_BTN_NAV1.2, J_BTN_ON1.2, J_BTN_REG1.2, J_BTN_RESET1.2, J_LCD1.1, J_RPM1.3, J_TEMP1.3, Q1.3 (S), Q2.1 (E), R4.1, R8.1, U2.2 (GND)
/MOTOR-: C11.2, D2.2 (A), J_MOTOR1.2, Q1.2 (D)
/PWM_MOTOR: A1.12 (D9), R3.1
/RESET: A1.3 (~RESET), A1.28 (~RESET), J_BTN_RESET1.1
/RPM_SIGNAL: A1.5 (D2), J_RPM1.2, R6.1
/SCL: A1.24 (A5), J_LCD1.4, R12.2
/SDA: A1.23 (A4), J_LCD1.3, R11.2
/TEMP_DATA: A1.7 (D4), J_TEMP1.2, R5.1

Notes on the sheet:
Conector (bornera) para el sensor RPM
C6 debe ir soldado al mismo nodo de +5V de la placa
Pantalla
conector del buzzer 5V
Regulador de 5V
Conector de entrada 12V
Todos los pines marcados con x no se ocuparán
Conector para el botón de encendido
condensador polarizado
Driver Buzzer
Conector (bornera) para el sensor de temperatura
conector del motor de 6 V
Regulador LS7805
Botones
Interfaz
Proyecto Bioreactor
Resistencias Pull-up
Microcontrolador
Driver Motor 12V
Entrada
C5 debe ir soldado al mismo nodo de +5V de la placa
Conector (bornera) para la pantalla

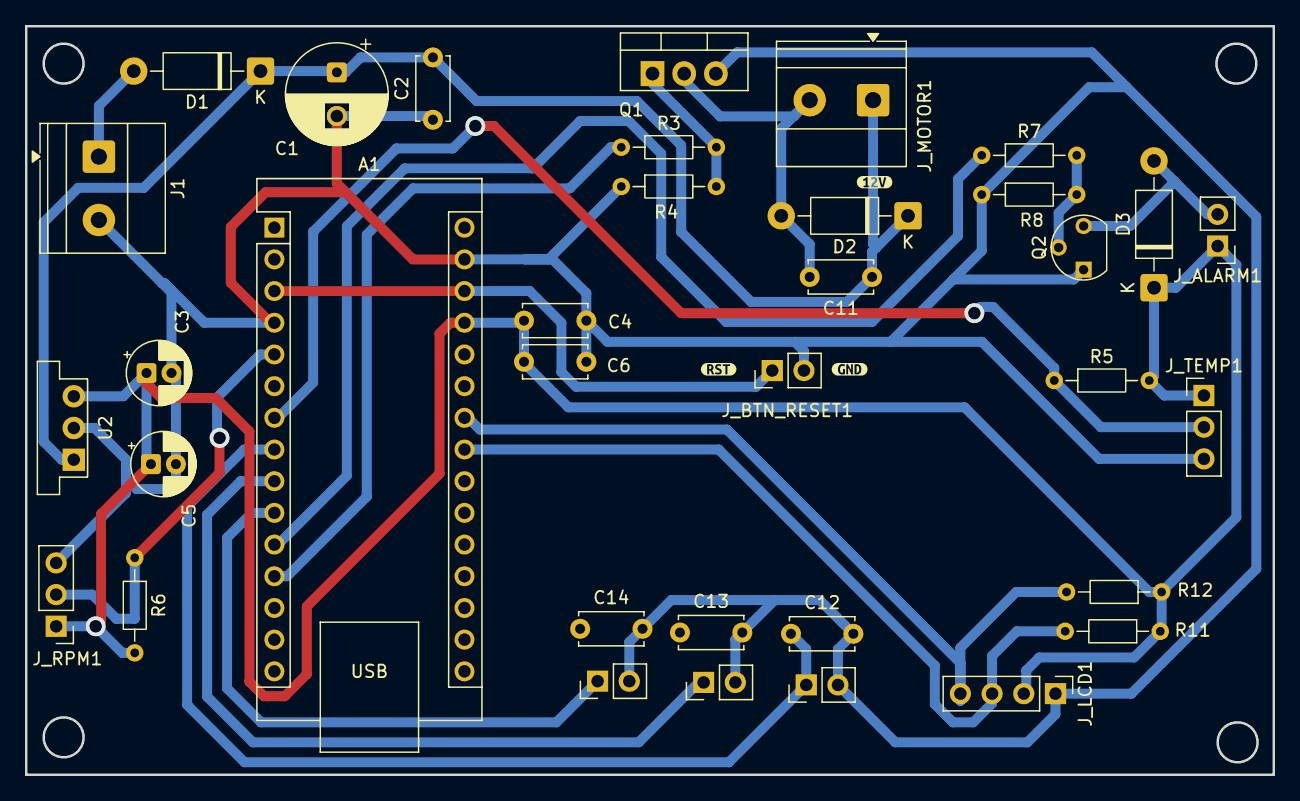
[picture p3: board Proyecto_bioreactor.kicad_pcb from above]

Board: 2 copper layers, 100.0 x 60.0 mm, 38 parts (0 on the bottom side), 18 nets.

Other parts of the board:
kibuzzard-6AE48D6D: G***; kibuzzard-6AE48D6D
kibuzzard-6AE48D38: G***; kibuzzard-6AE48D38
kibuzzard-6AE49500: G***; kibuzzard-6AE49500
