Jorgeherrera-hub/Proyecto-Electr-nica-Biom-dica-/Esquemático/reactor/reactor.kicad_pcb

## KiCad design Esquemático/reactor/reactor.kicad_pcb (2026-10-24)

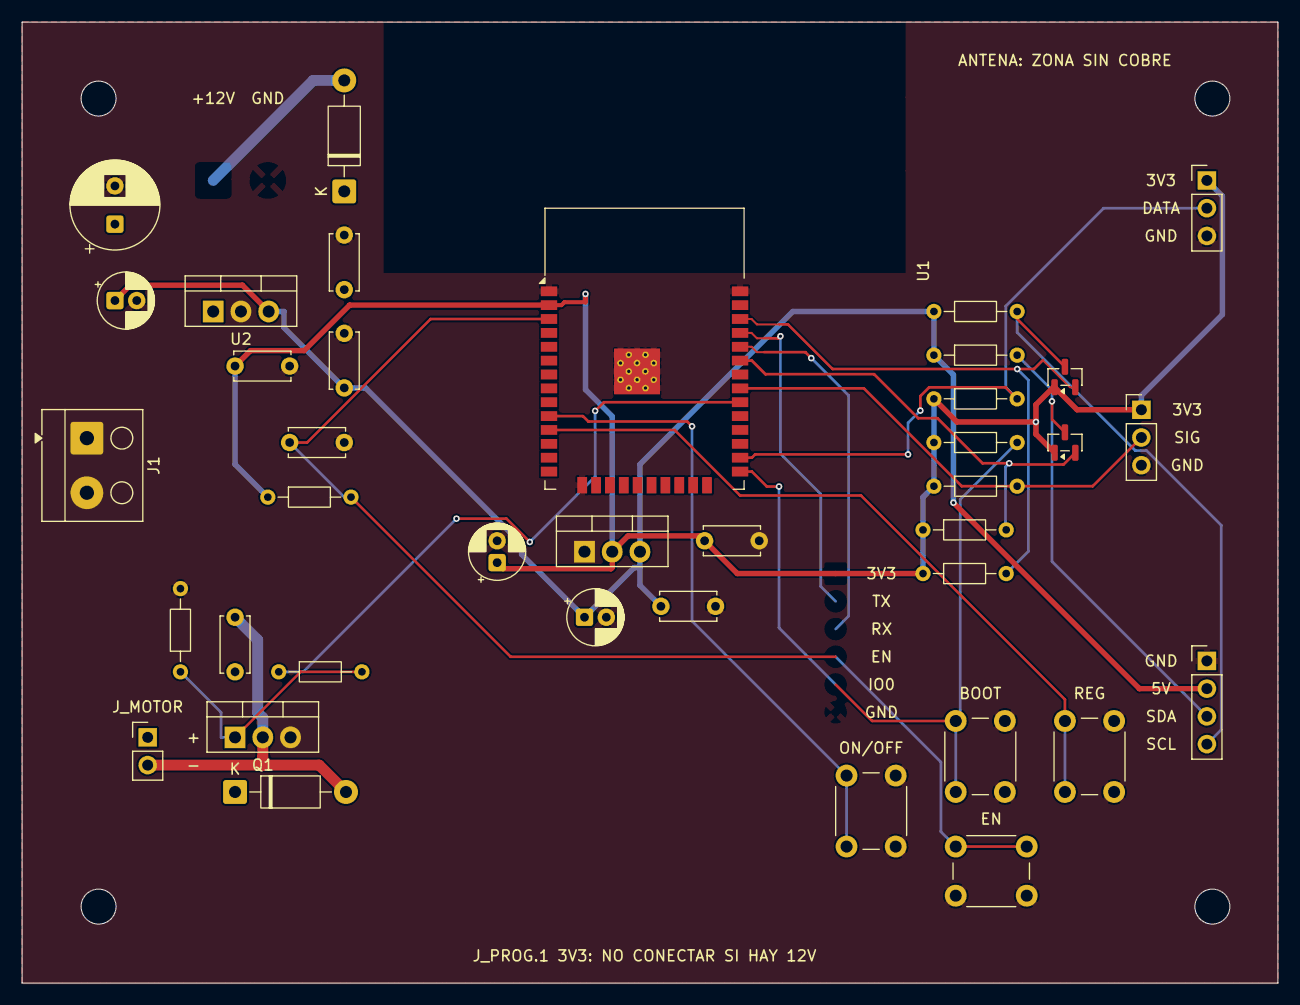
[picture p4: board reactor.kicad_pcb from above]

Board: 2 copper layers, 115.0 x 88.0 mm, 42 parts (0 on the bottom side), 18 nets.

Parts:
C1: 220uF 25V; CP_Radial_D8.0mm_P3.50mm
C2, C4, C6, C8, C9, C10, C11: 100nF; C_Disc_D5.0mm_W2.5mm_P5.00mm
C3, C5, C7: 10uF; CP_Radial_D5.0mm_P2.00mm
D1, D2: 1N5819; D_DO-41_SOD81_P10.16mm_Horizontal
H1, H2, H3, H4: M3; MountingHole_3.2mm_M3
J1: 12V DC IN; Altech_AK100_1x02_P5.00mm
J_LCD: LCD I2C 5V; PinHeader_1x04_P2.54mm_Vertical
J_MOTOR: MOTOR; PinHeader_1x02_P2.54mm_Vertical
J_RPM: RPM SENSOR 3V3; PinHeader_1x03_P2.54mm_Vertical
J_TEMP: DS18B20; PinHeader_1x03_P2.54mm_Vertical
Q1: IRLZ44N; TO-220-3_Vertical
Q2, Q3: BSS138; SOT-23
R1, R2, R4, R6, R7, R8, R9, R10: 10k; R_Axial_DIN0204_L3.6mm_D1.6mm_P7.62mm_Horizontal
R3: 100; R_Axial_DIN0204_L3.6mm_D1.6mm_P7.62mm_Horizontal
R5: 4.7k; R_Axial_DIN0204_L3.6mm_D1.6mm_P7.62mm_Horizontal
SW_BOOT: RESET/BOOT; SW_PUSH_6mm
SW_EN: RESET/BOOT; SW_PUSH_6mm
SW_ON: PUSHBUTTON; SW_PUSH_6mm
SW_REG: PUSHBUTTON; SW_PUSH_6mm
U1: ESP32-WROOM-32
U2: OKI-78SR-5/1.5-W36-C; TO-220-3_Vertical
U3: LM1117T-3.3; TO-220-3_Vertical

Connections:
+3V3: C7.1, C8.1, C9.1, J_RPM.1, J_TEMP.1, Q2.1, Q3.1, R1.1, R2.1, R5.1, R6.1, R7.1, R9.1, U1.2, U3.2
+5V: C3.1, C4.1, C5.1, C6.1, J_LCD.2, R8.1, R10.1, U2.3, U3.3
+12V_IN: D1.2, J1.1
+12V_PROT: C1.1, C2.1, C11.1, D1.1, D2.1, J_MOTOR.1, U2.1
EN: C10.1, R1.2, SW_EN.1, U1.3
GND: C1.2, C2.2, C3.2, C4.2, C5.2, C6.2, C7.2, C8.2, C9.2, C10.2, J1.2, J_LCD.1, J_RPM.3, J_TEMP.3, Q1.3, R4.2, SW_BOOT.2, SW_EN.2, SW_ON.2, SW_REG.2, U1.1, U1.15, U1.38, U1.39, U2.2, U3.1
IO0: R2.2, SW_BOOT.1, U1.25
MOTOR-: C11.2, D2.2, J_MOTOR.2, Q1.2
unnamed: Q1.1, R3.2, R4.1
unnamed: SW_ON.1, U1.10
unnamed: SW_REG.1, U1.11
PWM_MOTOR: R3.1, U1.30
RPM_SIGNAL: J_RPM.2, R6.2, U1.31
SCL_3V3: Q3.2, R9.2, U1.36
SCL_5V: J_LCD.4, Q3.3, R10.2
SDA_3V3: Q2.2, R7.2, U1.33
SDA_5V: J_LCD.3, Q2.3, R8.2
TEMP_DATA: J_TEMP.2, R5.2, U1.26
