Jorgeherrera-hub/Proyecto-Electr-nica-Biom-dica-/(commit log)

2026-10-16 Primera actualización proyecto
    [BOM_final.csv, mini_biorreactor.kicad_pcb, mini_biorreactor_final.dsn]
2026-10-23 wac review
    [reactor.kicad_pcb, reactor.kicad_sch]
2026-10-24 Nueva carpeta con proyecto nuevo (arduino nano R3)
    [Poryecto_bioreactor.kicad_pcb, Poryecto_bioreactor.kicad_sch]
2026-10-25 Esquemático terminado, generado de lista de componentes boom
    [BOM_con_huellas_v3 (1).csv, Poryecto_bioreactor.kicad_sch]
2026-10-25 actualizacion de esquemático
    [Poryecto_bioreactor.kicad_sch]
2026-10-25 Ruteado tentativo
    [Poryecto_bioreactor v3.1.kicad_pcb]
2026-10-30 PCB-Esquemático-Proyecto terminados
    [Proyecto_bioreactor.kicad_pcb, Proyecto_bioreactor.kicad_sch]
